makarcz/mkhbc8rx/ListOfParts_RTC_BRAM.odt

Number | Part Name | Qtty | Comment
1 | Euro 64-pin male connector | 1 | B2
2 | CR2032 battery holder | 1 | B4
3 | 32.768kHz Quartz Crystal Resonator | 1 | Resonator for RTC
4 | Resistor - 0.125 watt (lead spacing 0.25 inch) | 3 | 3k3, R9,10,11
5 | Cap - 0.1uf axial ceramic, decoupling (DigiKey 1210PHCT-ND) | 6 | C20,22,23,24,25,26
6 | IC socket Dip - 24 pin (0.6 inch) | 1 | U23
7 | IC socket Dip - 32 pin (0.6 inch) | 1 | U24
8 | IC socket Dip - 16 pin | 1 | U20
9 | IC socket Dip - 14 pin | 2 | U22,25
10 | IC socket Dip - 20 pin | 1 | U26
11 | Connector - Ribbon hdr, 10 pin (3M 2510-6002UB,DigiKeyMHB10K) | 1 | J7
12 | Jumper (2-pin) | 2 | J8,9
13 | Jumper 3-pin | 1 | J6
14 | IC DS1685 | 1 | U23, RTC
15 | IC WS628128 | 1 | U24, 128kB SRAM
16 | IC 74LS138 | 1 | U20, decoder
17 | IC 74LS00 | 2 | U22,25, NAND x 4
18 | IC 74LS374 | 1 | U26, latch
