makarcz/mkhbc8rx/(list of files, drawings)

Other design files:
mkhbc-8-r1-uart.pcb
mkhbc-8-r2-cpu.pcb
mkhbc-8-r2-rtc-bram.pcb
