makarcz/mkhbc8rx/(commit log)

2018-02-04 MKHBC-8-Rx homebrew 8-bit computer.
    Hardware blueprints and OS / firmware, libraries and applications for a
    homebrew MOS6502 based 8-bit general purpose hobby computer.
    [MKHBC-8-R2-CPU.sch, microchess.cfg, mkhbc-8-r1-uart.pcb, mkhbc-8-r2-cpu.pcb, mkhbc-8-r2-rtc-bram.pcb, mkhbc_mobo.cfg, mkhbc_sbc.cfg, mkhbcoslib.cfg]
2018-02-06 Development, bug fixes.
    Added kbhit implementation. Enhancements in enhshell.
    [mkhbc_mobo.cfg, mkhbcoslib.cfg]
2018-02-12 General development.
    RTC and BRAM detection added.
    Debug messages and conditional compilation in mkhbcos_mobo.asm.
    New program 'd2hb' (d2hexbin.c) added.
    New header file added mkhbcos_ml.inc with MKHBCOS definitions for
    assembly language programs.
    [mkhbcoslib.cfg]
2018-02-13 Bug fix.
    Bug fixed in detected devices flags.
    [mkhbcos_mobo.asm]
2018-02-16 Development, bug fixes.
    TB, older version, added memory bank initialization at beginning of COLD start.
    Added new program: enhmon.
    [enhmon.c, tinybasic.asm]
2018-02-17 Development, bug fixes.
    Initial version of ehnmon finished.
    [enhmon.c]
2018-02-18 Development, refactoring, bug fixes.
    New program: enhmon (enhmon.c) - development.
    Program: enhsh (enhshell.c) - refactoring and bug fixes.
    [enhmon.c]
2018-02-19 Development, refactoring, bug fixes.
    Programs enhmon.c and enhshell.c.
    Memory segments configuration for library: mkhbcoslib.cfg changed.
    Now TB BASIC pointers are not overwritten by MKHBCOS programs.
    Deleted hardcoded value of stack pointer from mkhbcos_ml.inc.
    Updated mkhbcos_lcd.s - not used currently so I kept forgetting.
    Added deleting of generated assembly code after library compilation -
    make_mkhbcoslib.bat.
    Delete generated assembly code from repository.
    Deleted obsolete implementation of puts.s.
    [mkhbcoslib.cfg]
2018-02-21 Development.
    Some refactoring in mkhbcos library.
    Started implementation of mkhbcrom library and program that will go to EPROM and will be an entry point for this library functions.
    [romlib.cfg]
2018-02-22 Development.
    Integrated firmware with CC65 initialization / startup code.
    Created new library mkhbcrom.lib, entry point program romlib.c and
    memory segment configuration romlib.cfg.
    Compilation / linking produces 8 kB image for EPROM.
    [romlib.cfg]
2018-02-23 Development.
    Firmware - new commands.
    ROM library, new functions.
    [romlib.cfg]
2018-02-23 Development.
    New functions in rom library and firmware / OS.
    Code optimizations.
    Memory segments configuration adjustments.
    [romlib.cfg]
2018-02-25 Development.
    Multiple changes and bug fixes + refactoring.
    Added commands to memory monitor.
    Optimized code.
    Updated documentation.
    [romlib.cfg]
2018-02-26 Development.
    Huge refactoring related to ROM library implementation.
    [mkhbcoslib.cfg, romlib.cfg]
2018-02-27 Development.
    Development and bug fixes related to ROM library.
    Documentation updated.
    [mkhbcoslib.cfg]
2018-02-27 Development.
    Memory configuration change.
    [mkhbcoslib.cfg, romlib.cfg]
2018-02-28 Development.
    Introduced makefile.
    Tiny Basic v 0.2.2 relocated to $0B00.
    BASIC memory increased.
    [tinybasic.cfg]
2018-03-02 Development.
    Tiny Basic relocation related changes.
    Added Enhanced Basic port. NOTE: It doesn't work yet.
    [ehbasic.cfg]
2018-03-03 Development.
    Porting Enhanced Basic.
    NOTE: This still doesn't work.
    [eh_basic.asm]
2018-03-08 Development.
    Attempt to port EhBasic failed.
    Relocated some ZP addresses.
    New starting address for apps.
    Added microchess to makefile. Note: microchess doesn't work properly.
    [microchess.cfg, romlib.cfg]
2018-03-12 Development and bug fixes.
    Programming workaround for microchess implemented for a conflict it has
    with RTC ISR.
    Optimized ISR.
    [microchess.cfg]
2018-03-13 Development and bug fixes.
    Added new functions to firmware and kernel jump table.
    [microchess.cfg, romlib.cfg]
2018-03-16 Development and bug fixes.
    Changes related mainly to micro-chess port, but also small cosmetic
    refactoring in the firmware.
    [microchess.cfg]
2018-04-02 Development and fixes.
    UART PCB linked to schematic.
    Development - text editor.
    [mkhbc-8-r1-uart.pcb]
2018-04-03 Development.
    Text Edit app.
    [mkhbcoslib.cfg]
2018-04-05 Development.
    Text Editor.
    Binary data loader.
    [himem.cfg, mkhbcoslib.cfg]
2018-04-05 Development. Bug fixes.
    Text editor.
    Binary file loader.
    Bug in kbhit().
    [himem.cfg]
2018-04-09 Development.
    The 'floader' (binary data stream loader) and PropTermMK related
    changes.
    [himem.cfg, mkhbcoslib.cfg]
2018-04-10 Development.
    Text Editor app.
    [mkhbcoslib.cfg]
2018-04-11 Development and bug fixes.
    - completed text editor
    - fixed bugs in bin2hex tool
    - reconfigured memory for mkhbcoslib and himem applications
    [himem.cfg, mkhbcoslib.cfg]
2018-04-15 Development and bug fixes.
    Text Editor - clipboard set to 3.5 kB. Fixed bug in RAM bank sanity
    check.
    bin2hex tool - added option -b BANK# to add monitor command setting RAM
    bank #.
    [bin2hex.c, texted.c]
2018-04-20 Development.
    6502 assembly compiler.
2018-05-01 Development
    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
2020-05-20 Update romlib.c
    Bug fixed. Passed pointer to pointer to arguments instead pointer to arguments in print string and get string functions.
    [romlib.c]
